AidanSmit0304/FuseBox2020/README.md

# FuseBox2020
Wazzu Racing Fusebox for 2020 Racecar

EAGLE:
.brd file for PCB, 
 .sch file for schematic, 
  zip file for PCB Manufacturing
