AidanSmit0304/FuseBox2020/2020 Electrical Design Presentation (1).pdf

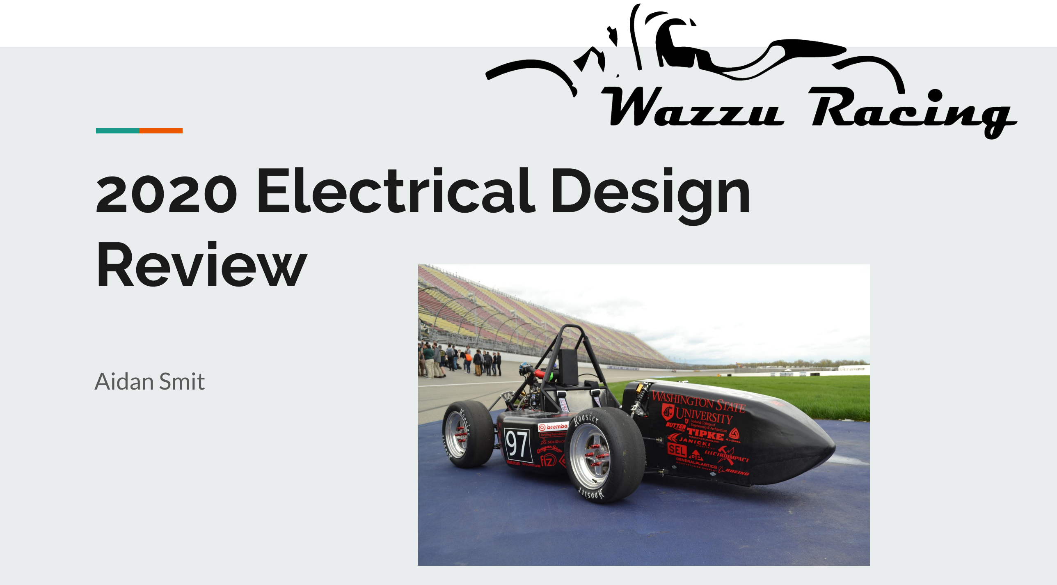
[picture p1: page 1]

# 2020 Electrical Design Review

### Aidan Smit

# Goals

1. Reduce material costs to fit limited budget
2. Fix ECU issues with proper grounding
3. Reduce complexity with cockpit wiring
4. Reduce complexity and size of harness
5. Improve other shortcomings of 97 including improper arc protection, lack of data acquisition

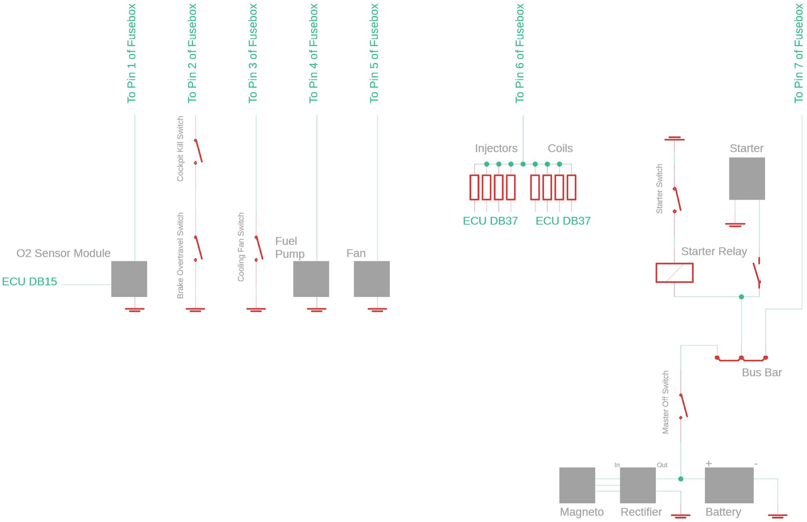
[picture p2: figure]

# General Schematic

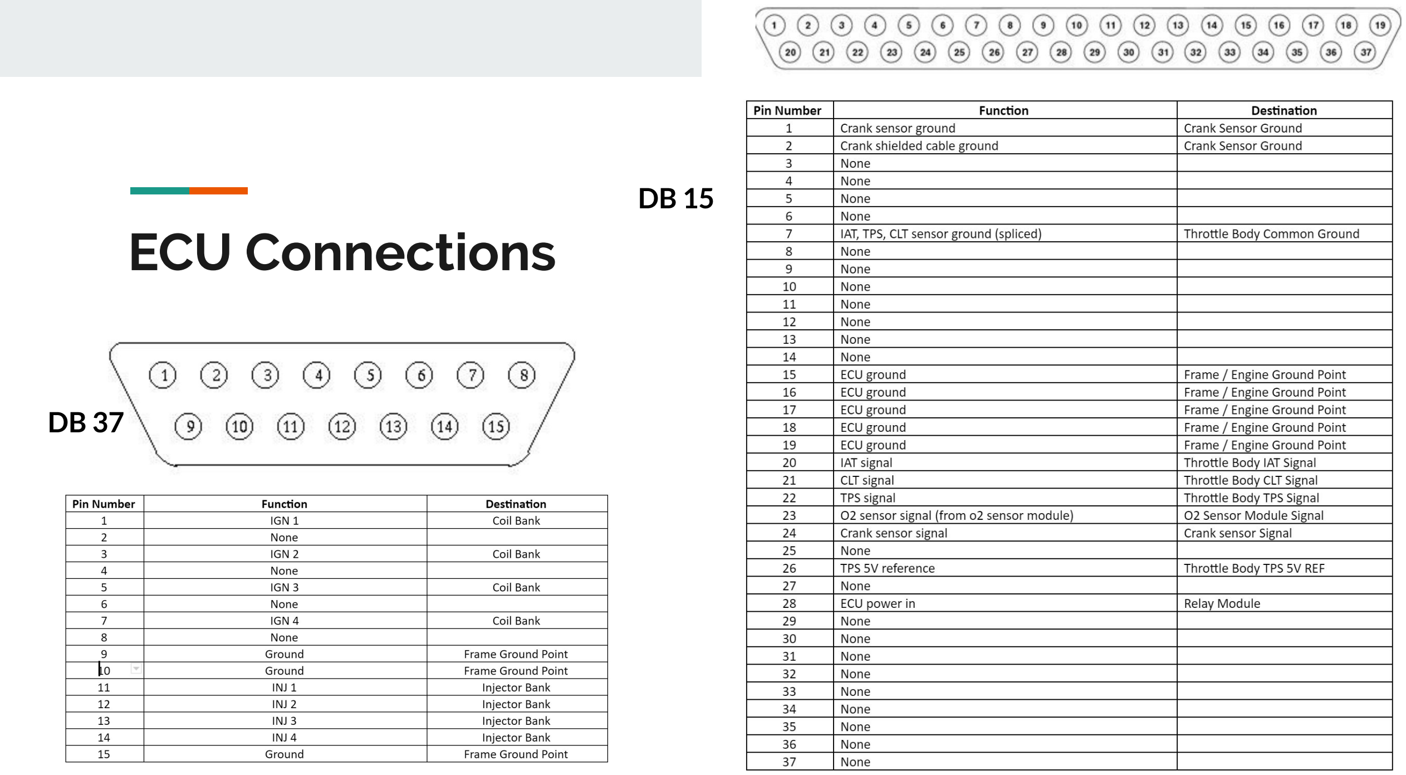
[picture p3: page 4]

DB 37

DB 15

# ECU Connections

# Manufacturing Schedule

Harness Design | 12.15.2019
Harness Materials Ordered | 12.31.2019
PCB Design | 12.15.2019
PCB Simulation/Checks | 12.25.2019
PCB Ordered | 12.31.2019
Final Assembly Manufactured | 02.01.2020 (team goal for starting car)
Final Testing and Improvements | 03.01.2020

# Goal 1: Reduce Cost

Items re-used from 2018-19 purchases:

- Rectifier
- Injector/Ign Sub-Harness
- Master switches
- Cockpit switches
- Extra Kapton tape
- Extra wiring
- Extra Heat shrink

97 Electrical Cost: $1,576.76 Current Electrical Cost: $139 Savings: $1437.76

# Goal 2: Fix ECU Issues with Proper Grounding

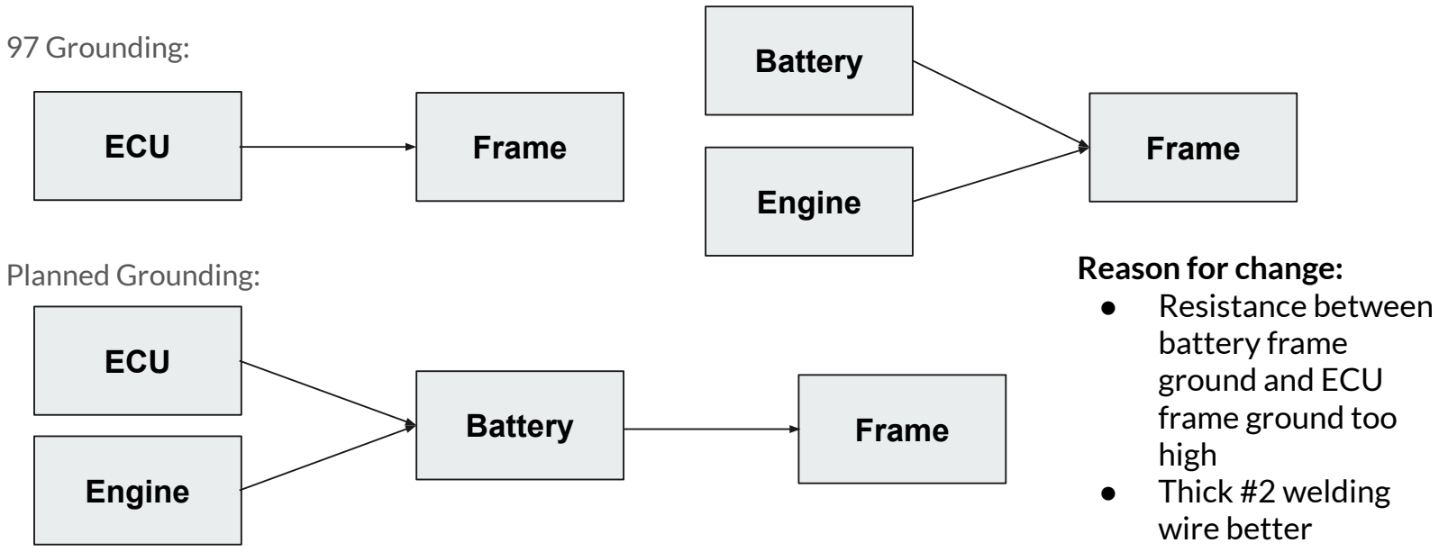
[picture p4: figure]
97 Grounding:; Planned Grounding:; ECU; Frame; Battery; high ● Thick #2 welding; Engine; frame ground too; wire better

Reason for change: ● Resistance between battery frame ground and ECU

# Goal 3: Reduce Complexity with Cockpit Wiring

- Move fuse/relay box to ‘sidepod’
- Custom box next to driver
- Custom pcb for fuses and relays
- Plug for components coming in and out of fuse box

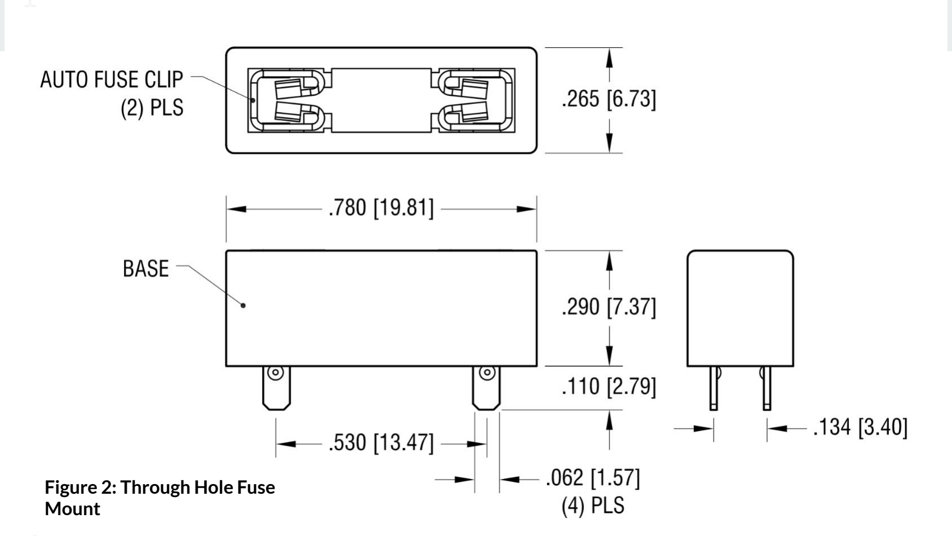
[picture p5: page 9]

Figure 2: Through Hole Fuse Mount

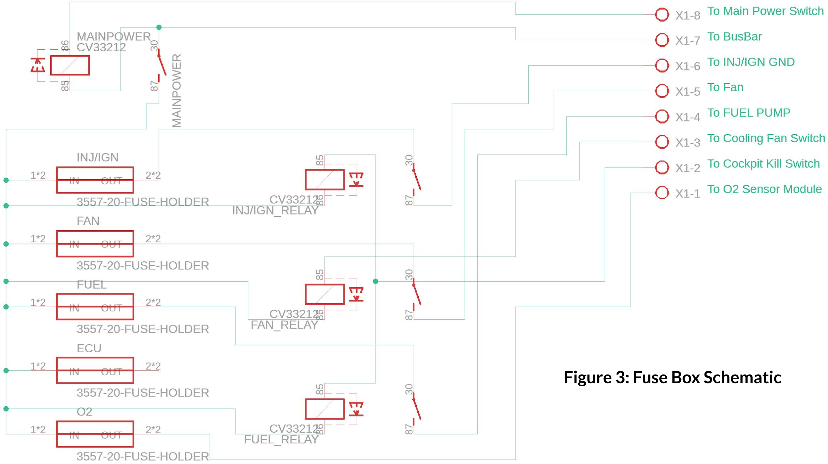
[picture p6: page 10]

Figure 3: Fuse Box Schematic

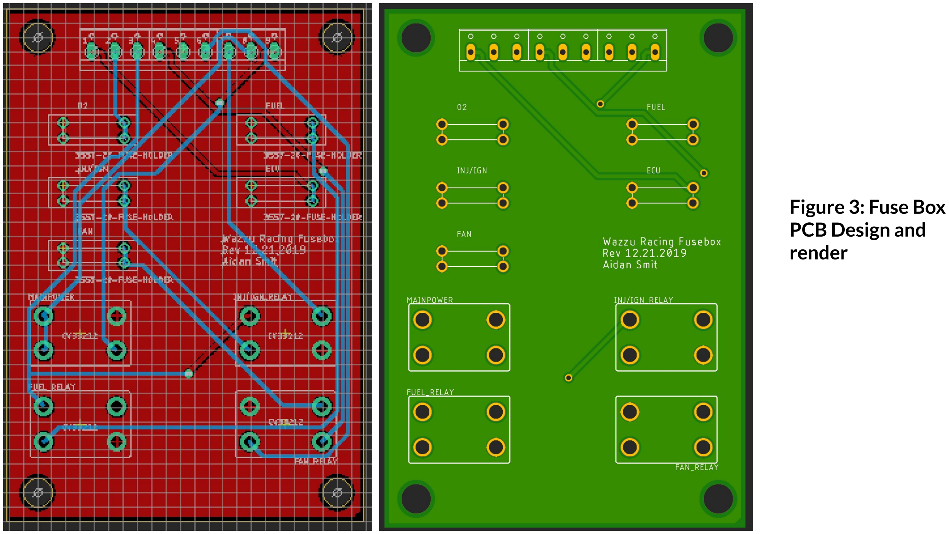
[picture p7: page 11]

Figure 3: Fuse Box
PCB Design and
render

# Goal 4: Reduce complexity and size of harness

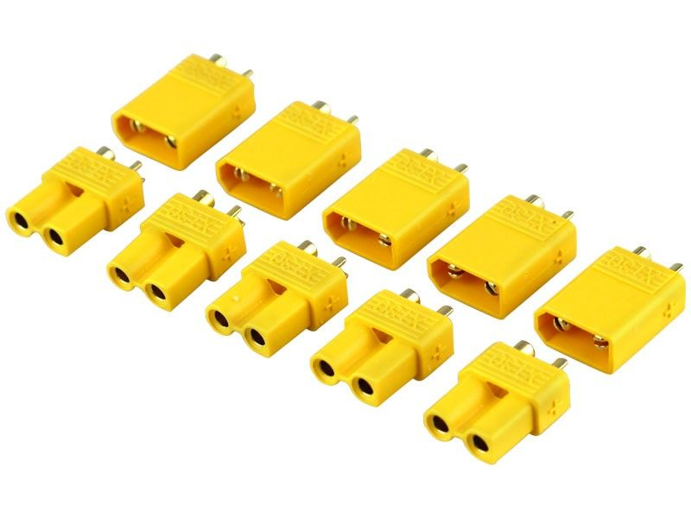
[picture p8: figure]

- Using XT30 connectors to shrink down the size of the
harness.
- Same connectors used in drones, RC planes, etc.
- Easy to waterproof
- Cheaper than old weather pack connectors
- Using thinner gauge wire for injectors and coils because we overestimated their size last time (18 gauge instead of 10 gauge)

# Goal 5: Improve other 97 car shortcomings

- Lack of data acquisition during competition
- Integration of electrical system with 2 Arduinos and Raspberry Pi
- See Data Acquisition design presentation with for more info
- Arc protection
- More custom 3d printed bolt caps for insulation
- Not forgetting bus bar plastic cover this year
- Proper heat shrinking on ALL wires
- Complimentary system
- Main electrical system, data acq., TCU, other subsystems all properly integrated
- Dependent, but one system failing will not kill the rest of the system
- Each component removable, replaceable
- Color Coding
- Can’t afford to color code wires or outer heat shrink, so we will color code heat shrink at the connectors
- Simple, yet effective

# Thank you! Any Questions?
