AidanSmit0304/FuseBox2020/fuse_holder.brd

## EAGLE design fuse_holder.brd (2019-12-22)

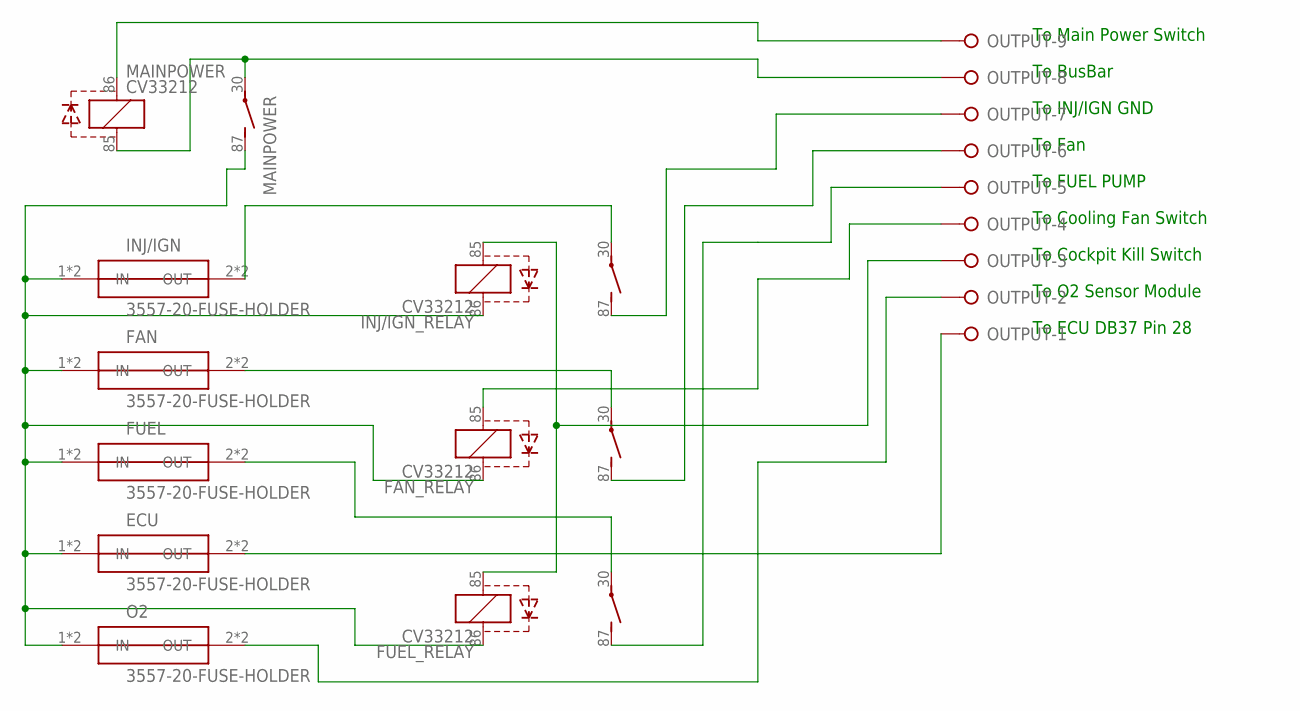
[picture p9: schematic fuse_holder.sch]

Parts:
ECU: 3557-20-FUSE-HOLDER
FAN: 3557-20-FUSE-HOLDER
FAN_RELAY: CV33212; CV1A-MICRO-280
FUEL: 3557-20-FUSE-HOLDER
FUEL_RELAY: CV33212; CV1A-MICRO-280
INJ/IGN: 3557-20-FUSE-HOLDER
INJ/IGN_RELAY: CV33212; CV1A-MICRO-280
MAINPOWER: CV33212; CV1A-MICRO-280
O2: 3557-20-FUSE-HOLDER
OUTPUT: W237-09P; W237-9P

Connections:
INJ/IGN_RELAY: ECU.1 (IN), ECU.3 (IN), FAN.1 (IN), FAN.3 (IN), FAN_RELAY.86 (+), FUEL.1 (IN), FUEL.3 (IN), FUEL_RELAY.86 (+), INJ/IGN.1 (IN), INJ/IGN.3 (IN), INJ/IGN_RELAY.86 (+), MAINPOWER.87 (S), O2.1 (IN), O2.3 (IN)
unnamed: MAINPOWER.86 (+), OUTPUT.9
unnamed: MAINPOWER.30, MAINPOWER.85 (-), OUTPUT.8
unnamed: INJ/IGN.2 (OUT), INJ/IGN.4 (OUT), INJ/IGN_RELAY.30
unnamed: FAN.2 (OUT), FAN.4 (OUT), FAN_RELAY.30
unnamed: FUEL.2 (OUT), FUEL.4 (OUT), FUEL_RELAY.30
unnamed: INJ/IGN_RELAY.87 (S), OUTPUT.7
unnamed: FAN_RELAY.87 (S), OUTPUT.6
unnamed: FUEL_RELAY.85 (-), INJ/IGN_RELAY.85 (-), OUTPUT.3
unnamed: FAN_RELAY.85 (-), OUTPUT.4
unnamed: O2.2 (OUT), O2.4 (OUT), OUTPUT.2
unnamed: ECU.2 (OUT), ECU.4 (OUT), OUTPUT.1

Notes on the sheet:
To BusBar
To Main Power Switch
To INJ/IGN GND
To Fan
To FUEL PUMP
To Cooling Fan Switch
To Cockpit Kill Switch
To O2 Sensor Module
To ECU DB37 Pin 28

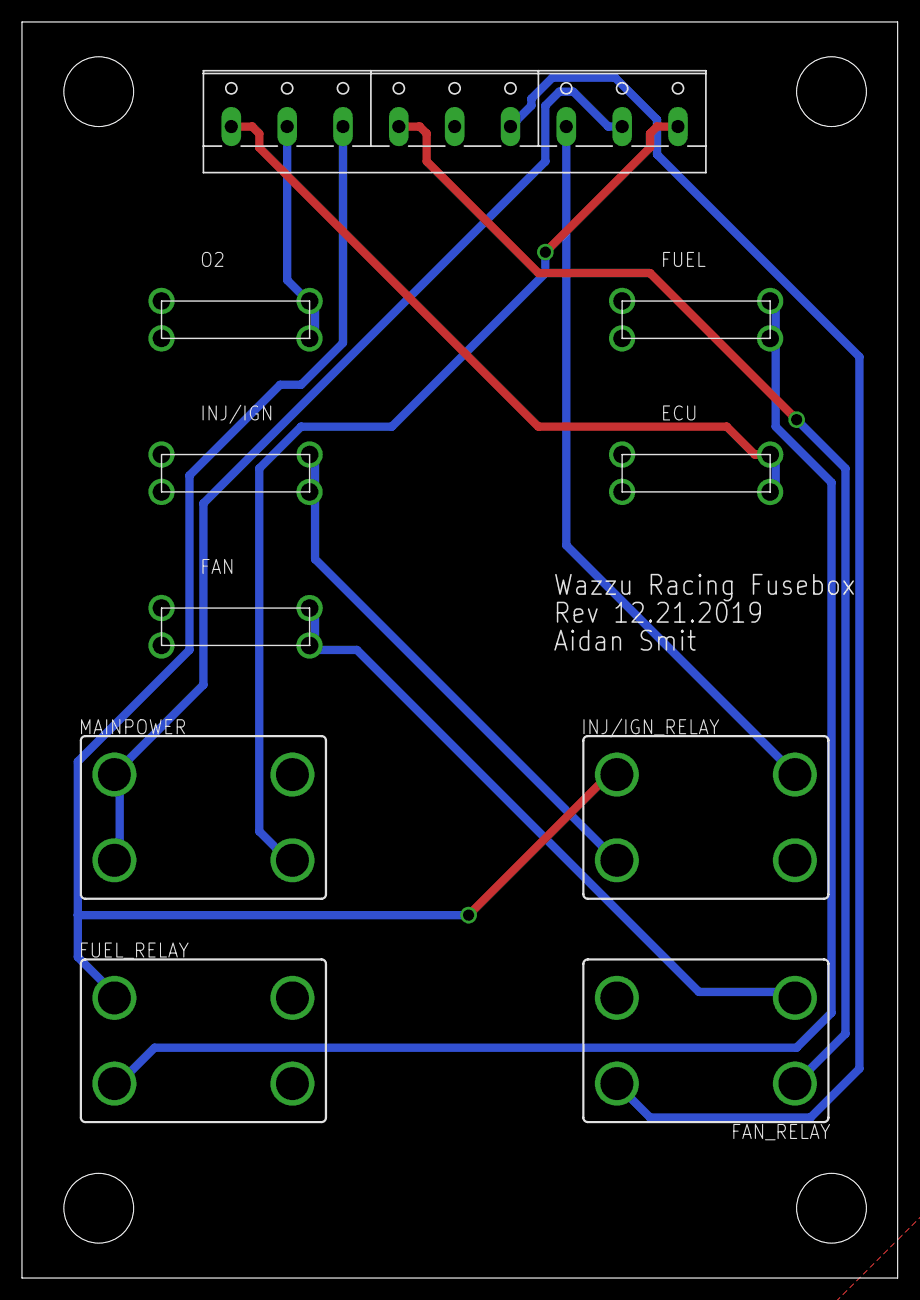
[picture p10: board fuse_holder.brd from above]

Board: 2 copper layers, 79.7 x 114.3 mm, 10 parts (0 on the bottom side), 12 nets.
